MichaelHviid/Futuretown-Patruljedysten/docs/Patruljedyst hardware.pdf

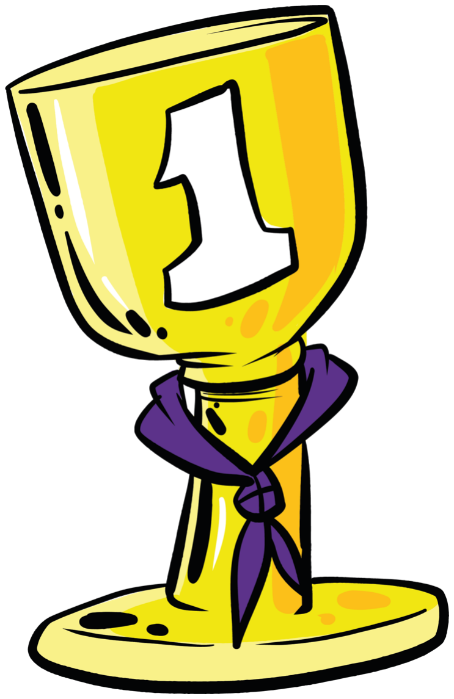
[picture p1: figure]

## Explore Together @ FutureTown

# Byggevejledning

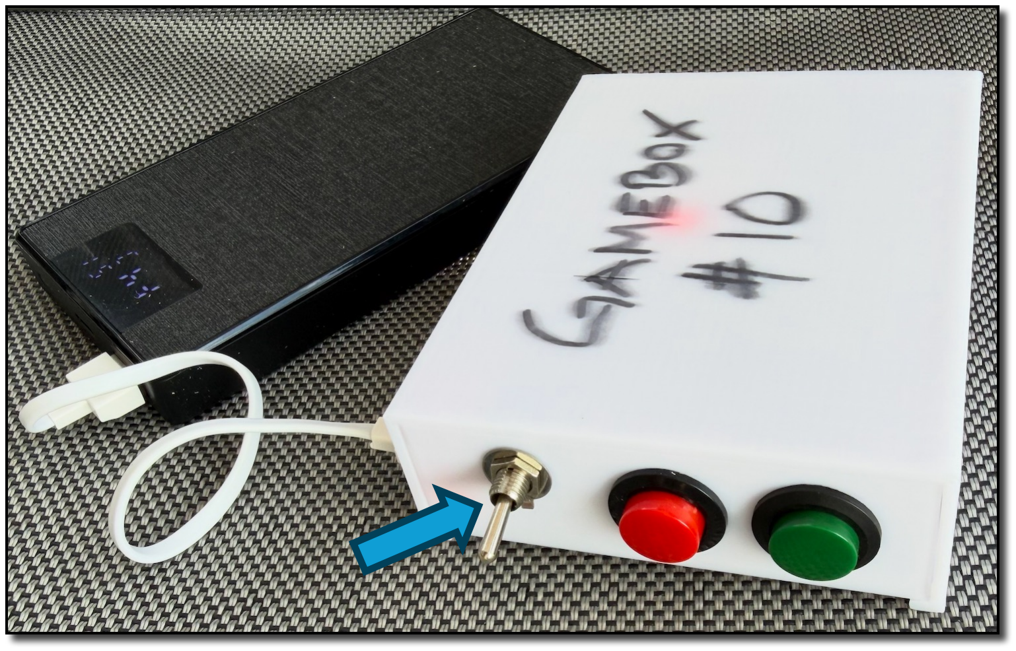
[picture p2: figure]

Vores små joysticks er 60 x 15 cm, ca 6 cm høje De store er 90 x 45 cm

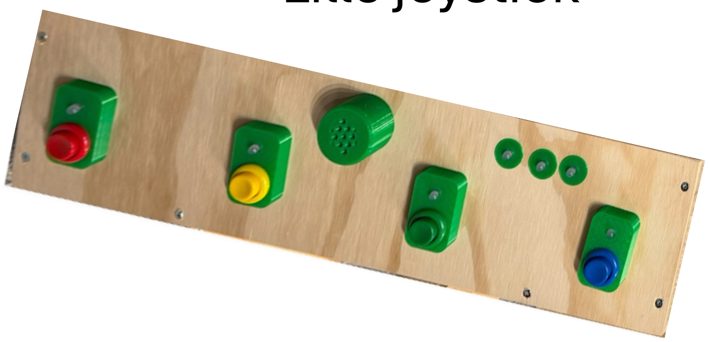
[picture p3: figure]
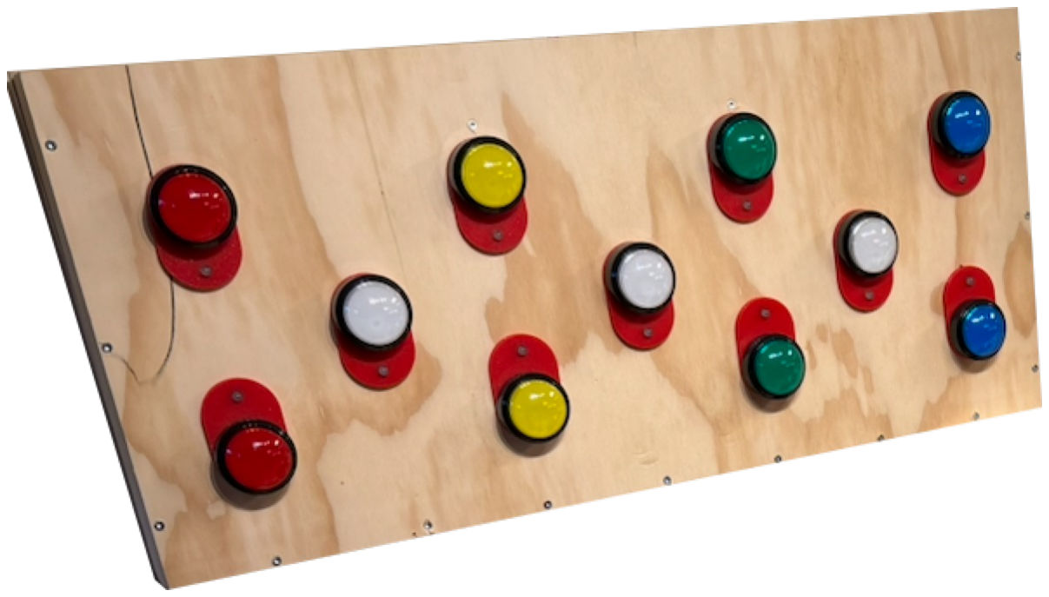
[picture p4: figure]

De små har højttalere, det har de store ikke.

Lille joystick

Stort joystick

## Explore Together @ FutureTown

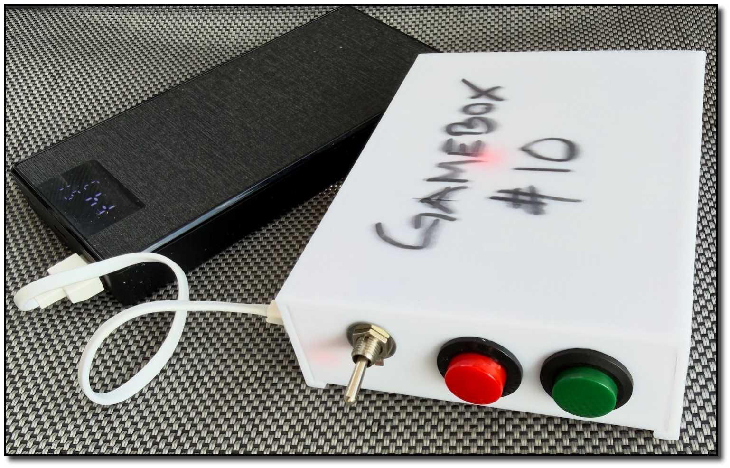
[picture p5: figure]

Vores Gamebokse består af 2 knapper
og et LED-bånd på 120pixels 2 meter langt.

Det fik power fra en alm. Powerbank via USB.

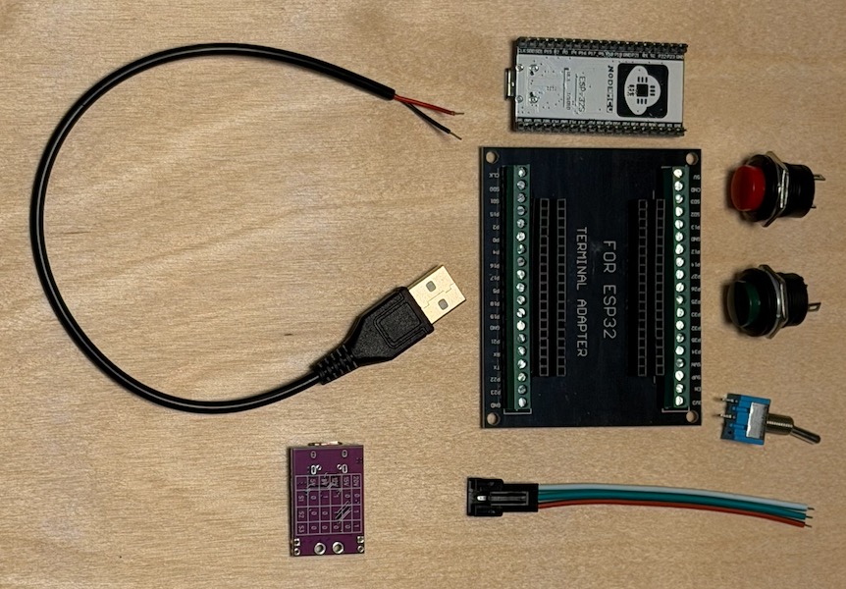
[picture p6: figure]

De fleste af vores bokse har et USB-C
til 5V print i sig. Men man kan også
bare bruge gammelt USB-kabel, så man får 5V. Vi har valgt at sætte en afbryder I,
men den er nok overflødig.

## Explore Together @ FutureTown

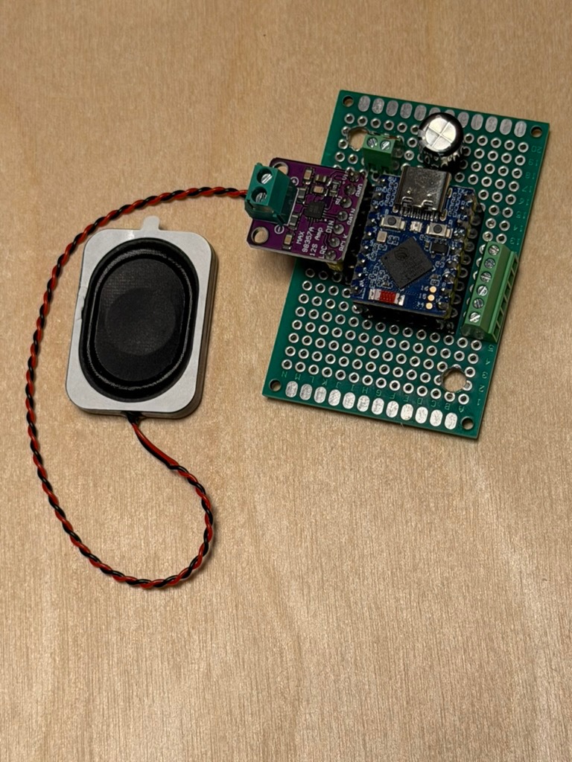
[picture p7: figure]
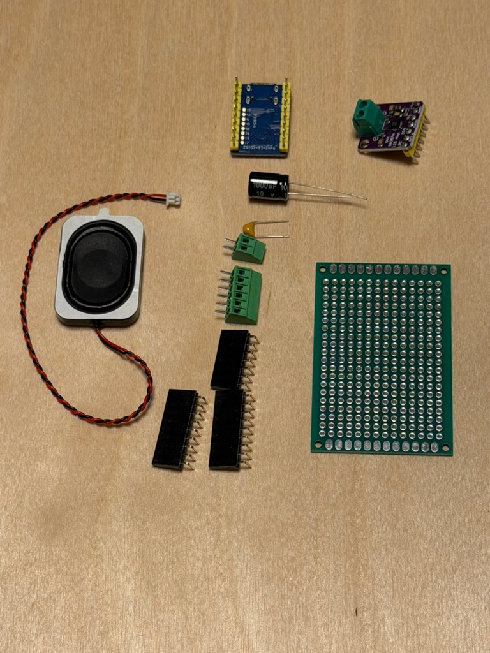
[picture p8: figure]

Vores Joysticks har vi valgt at lave et print til.

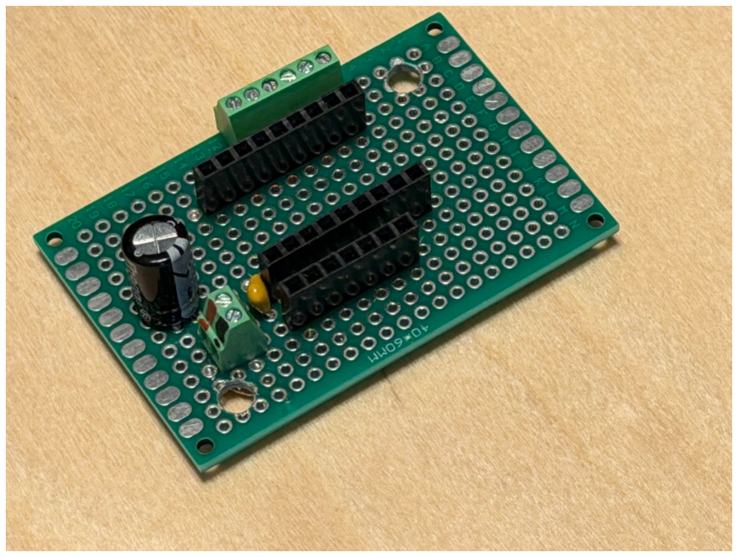
[picture p9: figure]

Der er 2 kondensatorer, da vi trækker strøm gennem LED-Strip, kan der opstå power-drops, det undgår vi med
Den store kondensator.
Den lille mindsker evt. Støj i højtaleren.

Vores næste version vlil få sin egen powerbank, så kan de undgåes helt.

Vi oplevede at de fleste fejl, var ledningsfejl I forbindelse med opsætning og nedtagning.

## Explore Together @ FutureTown

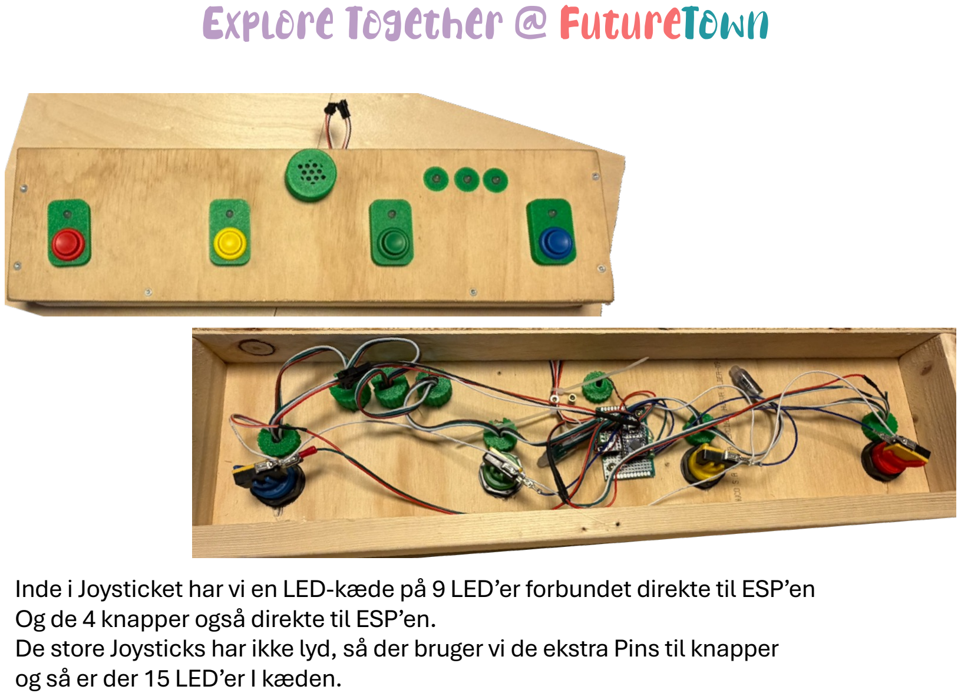
[picture p10: page 4]

Inde i Joysticket har vi en LED-kæde på 9 LED’er forbundet direkte til ESP’en Og de 4 knapper også direkte til ESP’en.
De store Joysticks har ikke lyd, så der bruger vi de ekstra Pins til knapper og så er der 15 LED’er I kæden.

## Explore Together @ FutureTown

Ud over alle de enkelte dele, skal man have en række mp3-filer.

De kan navngives 1.mp3, 2.mp3, 3.mp3 … osv op til 99.mp3

Nummeret modsvarer opsætningen for de enkelte spil m.m. som sættes I webinterfacet på gamebox’en.

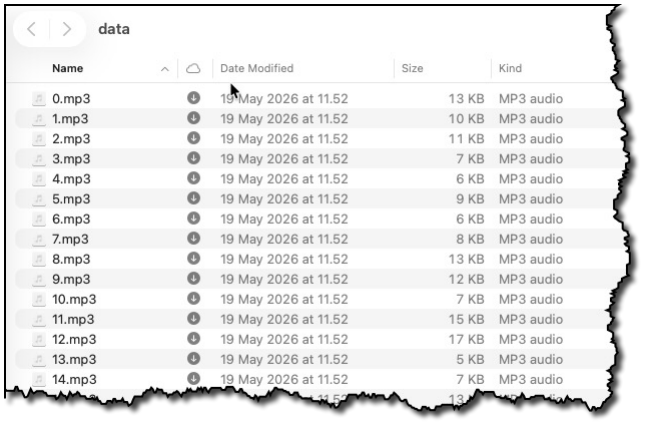
[picture p11: figure]
