MichaelHviid/Futuretown-Patruljedysten/docs/Patruljedyst vejledning.pdf

# Explore Together @ FutureTown

Aktivitetsnummer #7662 / #7663

# Patrol challenge - Gamers Edition

### Stops the game, on some Starts the game

boxes change the game.

### Off

On

### 1-3 Points

- Divide the group into patrols
- 4 players in each patrol. A Red, Yellow, Green and Blue player.
- Each game requires 2 patrols and one gamemaster (Leader)
- Gamemaster: Setup the game.
- Connect the gamebox to the powerbank, and turn it on.
- Wait until both joysticks sounds the readytune.
- Gamemaster: Play the challenge
- Press the green button (on the gamebox) to start the game. Both joysticks sounds the “Pacman tune” and each joystick flashes the color of the joystick (red or green).
- When both patrols hits any button the game begins.
- The game finishes when the joysticks flashes the winning color (red or green) and “Game over” sound in the speakers.
- Gamemaster, gives one winner-token to winning patrol, the patrol places the token on the scoreboard.
- Rules for each game are on the back of this instruction.

# Explore Together @ FutureTown

Aktivitetsnummer #7662 / #7663

# Patruljedysten - Gamers Edition

### Stopper spillet, på nogen Start spillet

boxe kan man skifte spil.

### Slukket Tændt

### 1-3 Point

- Opdel gruppen i patruljer • 4 spillere i hver patrulje, en rød, gul, grøn og blå spiller.
- Hvert udfordring kræver 2 patruljer og en Spildommer
| (gamemaster).
- Gamemaster: Klargør spillet.
- Forbind gameboxen med powerbank, tænd gamebox.
- Vent indtil begge joysticks har spillet en klarlyd.
- Farven Gamemaster: Start udfordringen
- Tryk på den grønne knap (på gameboxen) for at starte spillet.
| Begge joysticks kvitterer med en “Pacman tune” og begge joysticks blinker med hver sin banefarve (Rød og Grøn)
- Når patruljen er klar, trykker de på en knap på joysticket og spillet
| starter.
- En patrulje vinder udfordringen, når begge joysticks blinker
| vinderfarven (Rød eller Grøn). Man hører “Game over” på højtaleren.
- Gamemaster, overleverer en vindertoken – som sættes på
| scoreboardet.
- Vend vejledning for at læse reglerne for dette spil.

# Tovtrækning

## Tug of war

### Start position Grøn vinder / Green wins

This challenge requires each patrol to hit the buttons as fast as they can to pull the light towards them self.

If the patrol masters the skill to hit fast and simultaniously the game grants bonus strength.

The patrol who gets the light wins one point. 3 points to win the challenge.

I denne udfordring skal hver patrulje trykke så hurtigt de kan for at trække lyset ned mod dem selv. Hvis holdet mestre at trykke hurtigt og at alle spillere trykker synkront giver det bonus styrke.

Det hold der får tovet til enden har vundet et point. 3 point vinder udfordringen.

TURN over this instruction for general rules and start of the game.

### Vend denne vejledning for generelle regler og start af spillet

(1)

# Huske kimsleg

## Simon says

### Start position Grøn vinder / Green wins

TURN over this instruction for general rules and start of the game.

### Vend denne vejledning for generelle regler og start af spillet

Først lyser den første farve i sekvensen, når begge hold har husket rigtigt og trykket på den rigtige knap - lyser de første 2 farver – så de første 3, så 4… indtil een af holdene husker forkert. Husker begge hold forkert, får ingen point.

Spillet kræver ikke hastighed, men god hukommelse, lige som i kimsleg. Den patrulje der kan huske den længeste sekvens vinder 1 point. 3 point vinder udfordringen.

The first color in the sequence lights up. When both teams have remembered correctly and pressed the right button, the first 2 colors light up – then the first 3, then 4… until one of the teams remembers incorrectly. If both teams remember incorrectly, no one gets a point.

The game doesn't require speed, but a good memory – just like in memory. The patrol that remembers the longest sequence wins 1 point. 3 points wins the challenge.

### miss

(2)

# Pløk

## Color catcher

### Start position Grøn vinder / Green wins

TURN over this instruction for general rules and start of the game.

### Vend denne vejledning for generelle regler og start af spillet

Lige som i pløk, kræver dette spil hurtighed og præcision. Spillet starter med et grønt område til hvert hold. Fra midten vil der nu trille bolde i forskellige farver. Den farve spiller hvis bold matcher farven, skal trykke på sin knap, når bolden ER I DET GRØNNE område.

Misser man en bold eller trykker man når der ikke er nogen bolde i det grønne område får man en rød-straf pixel. Det hold der først får fyldt sin banehalvdel op med røde pixels, taber – og det modsatte hold får 1 point. 3 point vinder udfordringen.

This game requires speed and precision. The game starts with a green zone for each team. Balls in different colors will now roll out from the center. The player whose color matches the ball must press their button when the ball IS IN THE GREEN zone.

If you miss a ball, or press when there are no balls in the green zone, you get a red penalty pixel. The first team to have their half of the field filled up with red pixels loses – and the opposing team gets 1 point. 3 points wins the challenge.

(3)

# Fluen

## Speedball

### Start position

### Rød vinder / Red wins

TURN over this instruction for general rules and start of the game.

### Vend denne vejledning for generelle regler og start af spillet

Dette spil kræver præcision. Spillet starter med et farvet område til hvert hold. Fra midten vil der nu trille een bold mod det ene hold. Den spiller hvis knap lyser skal trykke på sin knap, når bolden ER I DET FARVEDE område. Trykker man mens bolden er i de grønne område returneres bolden i samme hastighed. I det gule hurtigere, I det røde endnu hurtigere… med tiden kommer der et blåt og et hvidt område – som returnerer som lynet…
Trykker man på Knappen når det ikke er ens tur, eller når bolden ikke er i det farvede område får modstanderholdet bonus pixels, hvide og blå…
Misser man en bold får det modsatte hold 1 point. 3 point vinder udfordringen.

This game requires precision. The game starts with a colored zone for each team. One ball will now roll from the center toward one of the teams. The player whose button lights up must press their button when the ball IS IN THE COLORED zone. If you press while the ball is in the green zone, the ball is returned at the same speed. In the yellow zone it returns faster, in the red zone even faster… over time, a blue and a white zone will appear – which return the ball at lightning speed… If you press the button when it's not your turn, or when the ball is not in the colored zone, the opposing team gets bonus pixels, white and blue…
If you miss a ball, the opposing team gets 1 point. 3 points wins the challenge.

(4)

# Mulvarpespil

## Whac a mole

### Start position Grøn vinder / Green wins

TURN over this instruction for general rules and start of the game.

### Vend denne vejledning for generelle regler og start af spillet

I dette spil skal I samarbejde om at trykke på de knapper der lyser. Dette spil spilles med de store joysticks.
Når en knap lyser – vil den lyse på begge holds joystick. Det hold der trykker først på knappen får et point. Point vises på led-strip.

Det hold der først får fyldt sin banehalvdel op har vundet denne udfordring.
Der spilles kun een runde.

In this game you cooperate to hit the buttons that lights up. This game plays with the large joysticks.
When a button lights up – it will light up on both teams' joysticks. The team that presses the button first gets a point. Points are shown on the LED strip.
The first team to fill up their half of the field wins this challenge.
Only one round is played.

(7)

# Pind

## Chain reaction

### Start position Grøn vinder / Green wins

TURN over this instruction for general rules and start of the game.

### Vend denne vejledning for generelle regler og start af spillet

I denne udfordringen, skal I skyde en pind mellem jeres 2 hold, man returnere pinden når den er i det grønne område. Den spiller hvis farve matcher pinden skal returnere pinden.
Pinden skifter farve når den returneres.

Misser man en pind, får det modsatte hold 1 point. 3 point vinder udfordringen.

In this challenge, you shoot a stick between your 2 teams. You return the stick when it is in the green zone. The player whose color matches the stick must return it.
The stick changes color when it is returned.

If you miss a stick, the opposing team gets 1 point. 3 points wins the challenge.

(6)

# 2 personers mulvarpespil

## 2 player ”whac a mole”

### Start position Grøn vinder / Green wins

TURN over this instruction for general rules and start of the game.

### Vend denne vejledning for generelle regler og start af spillet

Dette spil spilles alene, det er faktisk for nemt hvis man er flere …

Når en knap lyser – vil den lyse på begge joysticks. Nu skal der trykkes på den farve knap, der matcher farven på den diode der lyser, uanset hvilken knap den lyser ud for.

Den spiller der trykker først på knappen får pixels på sin banehalvdel. Den spiller der først får sin banehalvdel fyldt op, får 1 point. Den spiller der først får 3 point vinder denne challenge.

This game is played alone – it's actually too easy if there are several of you…

When a button lights up – it will light up on both joysticks. You must now press the button whose color matches the color of the lit LED, regardless of which button it lights up next to.

The player who presses the button first gets pixels on their half of the field. The player who fills up their half of the field first gets 1 point. The first player to get 3 points wins this challenge.

(5)
