MichaelHviid/Futuretown-Patruljedysten/(commit log)

2026-07-31 Patruljedysten – Gamers Edition · offentlig udgivelse
    ESP32-baseret holdspil: gamebox (LED-strip + spil), trådløse joysticks
    og remote — med Vue web-admin, vejledning og CC BY-NC 4.0-licens.
2026-07-31 docs: stykliste og wirediagram for gamebox og joystick
    Tilføjer hardware-dokumentation (BOM + pin-oversigt + Mermaid-wirediagram)
    for begge enheder, og linker dem fra README.
2026-07-31 docs: ret hardware til faktisk opbygning
    - Gamebox: fjern serie-modstand og level shifter (data går direkte).
    - Joystick: 9 LED (lille) / 15 LED (stor); tilføj 100 µF + 100 nF kondensator.
2026-07-31 docs: fjern onboard status-pixels fra styklister
    Status-LED (gamebox GPIO 2) og status-NeoPixel (joystick GPIO 21) er
    onboard og hører ikke i styklisten – de fremgår nu kun af wiring.
2026-07-31 docs: stor joystick har knapper paa GPIO 1-11
    Opdel wiring og wirediagram i lille (GPIO 7-10 + lyd) og stor model
    (11 knapper paa GPIO 1-11, LED-kaede paa GPIO 12, ingen lyd).
2026-07-31 docs: tilfoej PDF-vejledninger og opdater hardware-pptx
    - Tilfoej Patruljedyst vejledning.pdf og Patruljedyst hardware.pdf (vises direkte paa GitHub).
    - Opdater hardware-PowerPointen.
    - README: erstat PDF-tip med links til de to PDF'er.
    - Fjern Office-laasefil fra repo og ignorer ~$* fremover.
